wallago/kagu/CHANGELOG.md

# Changelog

## 0.3.0 - 2026-11-07

### 🚀 Features

- *(keymap)* Add session switch f2/f3 by @wallago
- *(keymap)* Add session switch f2/f3 by @wallago
- *(keymap)* Generate the keymap from keymap.txt and adopt a dubu36-style layout  by @wallago in [#20](https://github.com/wallago/kagu/pull/20)
- *(firmware)* Drive a 1.47" ST7789 status screen on the left half  by @wallago in [#11](https://github.com/wallago/kagu/pull/11)
- *(keymap)* Add home row mods and a Miryoku-style layer set  by @wallago in [#16](https://github.com/wallago/kagu/pull/16)

### 🛡️ Security

- *(deps)* Bump actions/download-artifact from 4 to 8  by @dependabot[bot] in [#1](https://github.com/wallago/kagu/pull/1)

## New Contributors
* @dependabot[bot] made their first contribution in [#5](https://github.com/wallago/kagu/pull/5)

**Full Changelog**: https://github.com/wallago/kagu/compare/v0.2.0...v0.3.0

## 0.2.0 - 2026-10-31

### 🚀 Features

- *(case)* Default tilted risers to a 2 mm post by @claude
- *(case)* Print tilted risers standing on the stem tip by @claude
- *(case)* Default the riser to no collar and render 15/25/35 degree leans by @claude
- *(case)* Add a collar-free riser option by @claude in [#9](https://github.com/wallago/kagu/pull/9)
- *(case)* Default the riser to the 0.5 mm post confirmed in print by @claude
- *(case)* Make the riser grip the switch and allow a 0.5 mm post by @claude
- *(case)* Tighten the riser stem and add tilted risers by @claude
- *(case)* Swap the tower caps for a straight Choc v2 riser by @claude
- *(case)* Add Choc v2 tower keycaps by @claude
- *(case)* Add five more top plate supports by @claude in [#7](https://github.com/wallago/kagu/pull/7)
- *(case)* Add support pillars under the top plate by @claude
- *(case)* Close battery JST window on top plate by @claude
- *(case)* Close reset hole and unused JST windows on top plate by @claude
- *(case)* Add top plate by @claude
- *(case)* Add a 1/4" nut mount at the tray's balance point by @claude in [#8](https://github.com/wallago/kagu/pull/8)
- *(case)* Add relief round the tray's heat-set inserts by @claude
- *(config)* Make full left layout by @wallago in [#3](https://github.com/wallago/kagu/pull/3)
- *(pcb)* Send to prod for one half (gl) by @wallago
- *(pcb)* Make a first no error version by @wallago
- *(pcb)* Init project by @wallago
- *(firware)* Add rgb led status by @wallago
- *(case)* Add bottom case and tilter by @wallago
- *(config)* Make both halves by @wallago
- *(pcb)* Match both sides by @wallago
- *(pcb/ritght)* Update it by @wallago
- *(pcb/right)* Initialize it by @wallago
- *(pcb)* Send to prod for one half (gl) by @wallago
- *(pcb)* Make a first no error version by @wallago
- *(pcb)* Init project by @wallago
- *(firware)* Add rgb led status by @wallago

### 🐛 Bug Fixes

- *(cd)* Release firmware and gerbers instead of a Rust binary  by @wallago in [#12](https://github.com/wallago/kagu/pull/12)
- *(case)* Stop mirroring switch rotations from the PCB by @claude
- *(ci)* Fix the jobs that fail on every run by @claude
- *(keymap)* Drop leftover merge conflict block by @claude in [#6](https://github.com/wallago/kagu/pull/6)
- *(pcb/left)* Adjust edge to fit right constraints by @wallago

### 🚜 Refactor

- *(pcb)* Rename it by @wallago

### 📚 Documentation

- *(case)* Say the riser stem is thickened, not opened up by @claude

### ⚙️ Miscellaneous Tasks

- *(release)* V0.2.0 by @wallago
- *(case)* Drop the tilter and the old one-piece case by @claude in [#10](https://github.com/wallago/kagu/pull/10)
- *(rebase)* Resolve to conflict by @wallago
- *(gitignore)* Update kicad ignored files by @wallago

## New Contributors
* @claude made their first contribution in [#10](https://github.com/wallago/kagu/pull/10)

**Full Changelog**: https://github.com/wallago/kagu/compare/v0.1.0...v0.2.0

## 0.1.0 - 2026-08-16

### 🚀 Features

- Add ZMK shield for single-key smoke test by @wallago

### 🐛 Bug Fixes

- *(zmk)* Move shield under config/ board root by @wallago
- *(zmk)* Chip as changing name by @wallago

## New Contributors
* @wallago made their first contribution

<!-- generated by git-cliff -->
