wallago/kagu/case/kagu_left_geom.scad

// GENERATED by case/extract_geometry.py -- do not edit.
// Source: pcb/kagu-left/kagu.kicad_pcb

board_w = 127;
board_h = 91.5;

// Board outline, counter-clockwise, origin at bounding-box corner.
outline = [ [0, 76.5], [0, 22], [26, 22], [30, 34], [41.5, 34], [53.5, 12.5], [72.5, 12.5], [106, 0], [127, 37], [127, 82.5], [77.5, 82.5], [77.5, 84.5], [61.5, 84.5], [61.5, 91.5], [40.5, 91.5], [40.5, 85.5], [22.5, 85.5], [22.5, 76.5] ];

// M3 mounting holes.
screws = [ [122, 35.5], [45, 35.5], [3.5, 25.5], [3.5, 73], [123.5, 79] ];

// Switch centres as [x, y, rotation].
switches = [ [15, 64.5, -0], [63, 21.5, -180], [87, 39.5, -0], [69, 41.5, -0], [51, 48.5, -0], [33, 76.5, -0], [51, 82.5, -0], [104, 15.5, 120], [87, 56.5, -0], [69, 75.5, -0], [83, 18.5, -160], [69, 58.5, -0], [87, 73.5, -0], [33, 59.5, -0], [15, 30.5, -0], [15, 47.5, -0], [51, 65.5, -0], [33, 42.5, -0] ];

// Components taller than the plate gap: [x0, y0, x1, y1].
tall_parts = [
    [111.5, 39.6, 119.5, 47.2],  // Switch_Con1
    [101.5, 39.6, 109.5, 47.2],  // Bat_Con1
    [103, 24.98, 108.7, 30.57],  // Bat_LED_Con1
];

// XIAO board cutout [x0, y0, x1, y1].
xiao = [101.8, 59.99, 119.6, 80.95];

// USB-C connector envelope [x0, y0, x1, y1].
usb = [106.2, 81.04, 115.2, 82.55];

// Reset button centre.
reset = [116, 32.5];
