wallago/kagu/case/kagu_right_geom.scad

// GENERATED by case/extract_geometry.py -- do not edit.
// Source: pcb/kagu-right/kagu.kicad_pcb

board_w = 127;
board_h = 91.5;

// Board outline, counter-clockwise, origin at bounding-box corner.
outline = [ [0, 37], [0, 82.5], [49.5, 82.5], [49.5, 84.5], [65.5, 84.5], [65.5, 91.5], [86.5, 91.5], [86.5, 85.5], [104.5, 85.5], [104.5, 76.5], [127, 76.5], [127, 22], [101, 22], [97, 34], [85.5, 34], [73.5, 12.5], [54.5, 12.5], [21, 0] ];

// M3 mounting holes.
screws = [ [5, 35.5], [82, 35.5], [123.5, 25.5], [123.5, 73], [3.5, 79] ];

// Switch centres as [x, y, rotation].
switches = [ [112, 64.5, -0], [64, 21.5, -180], [40, 39.5, -0], [58, 41.5, -0], [76, 48.5, -0], [94, 76.5, -0], [76, 82.5, -0], [23, 15.5, -120], [40, 56.5, -0], [58, 75.5, -0], [44, 18.5, 160], [58, 58.5, -0], [40, 73.5, -0], [94, 59.5, -0], [112, 30.5, -0], [112, 47.5, -0], [76, 65.5, -0], [94, 42.5, -0] ];

// Components taller than the plate gap: [x0, y0, x1, y1].
tall_parts = [
    [7.55, 39.6, 15.45, 47.2],  // Switch_Con1
    [17.55, 39.6, 25.45, 47.2],  // Bat_Con1
    [18.27, 24.98, 23.95, 30.57],  // Bat_LED_Con1
];

// XIAO board cutout [x0, y0, x1, y1].
xiao = [7.444, 59.99, 25.22, 80.95];

// USB-C connector envelope [x0, y0, x1, y1].
usb = [11.82, 81.04, 20.82, 82.55];

// Reset button centre.
reset = [11, 32.5];
