wallago/kagu/case/left.scad

// Entry point for the left half. Render with:
//   openscad -D 'part="bottom"' -o build/kagu_left_bottom.stl case/left.scad
include <kagu_left_geom.scad>
include <kagu_case.scad>
