wallago/kagu/case/left_tray.scad

// Entry point for the left half's bottom tray. Render with:
//   openscad -o build/kagu_left_tray.stl case/left_tray.scad
include <kagu_left_geom.scad>
include <kagu_tray.scad>
