wallago/kagu/case/right.scad

// Entry point for the right half. Render with:
//   openscad -D 'part="bottom"' -o build/kagu_right_bottom.stl case/right.scad
include <kagu_right_geom.scad>
include <kagu_case.scad>
