wallago/kagu/case/right_tray.scad

// Entry point for the right half's bottom tray. Render with:
//   openscad -o build/kagu_right_tray.stl case/right_tray.scad
include <kagu_right_geom.scad>
include <kagu_tray.scad>
