wallago/kagu/pcb/kagu-right/kagu.kicad_pcb

## KiCad design pcb/kagu-right/kagu.kicad_pcb (2026-09-24)

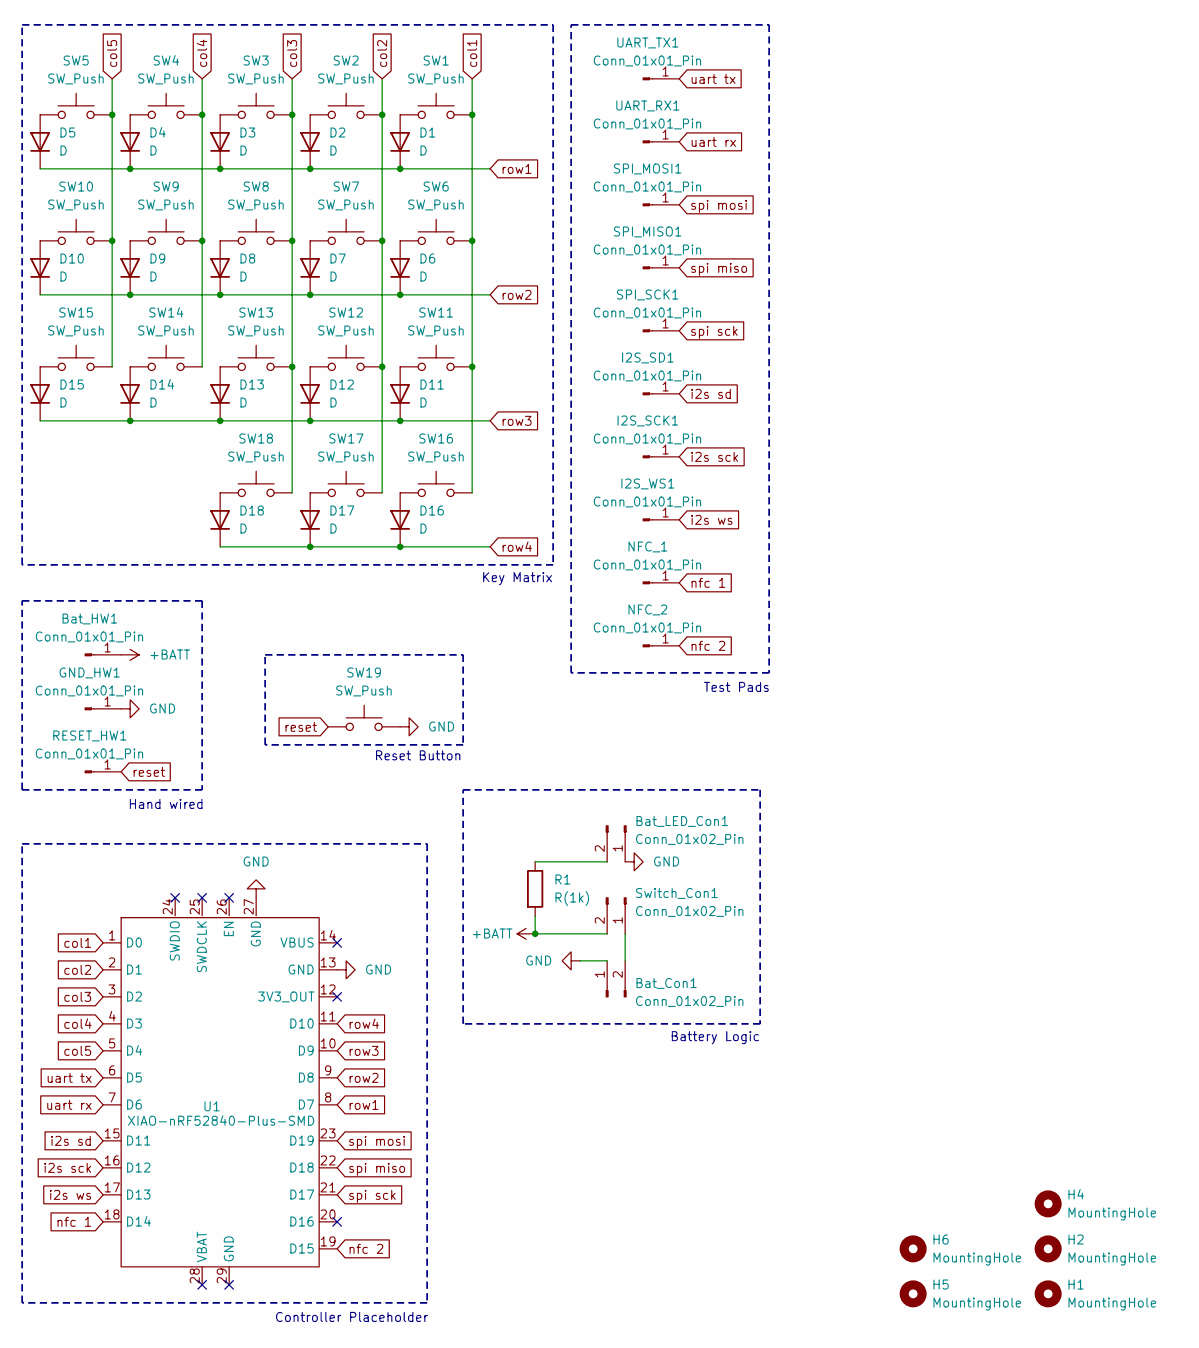
[picture p1: schematic kagu.kicad_sch]

Parts:
Bat_Con1: Conn_01x02_Pin; JST_PH_S2B-PH-SM4-TB_1x02-1MP_P2.00mm_Horizontal
Bat_HW1: Conn_01x01_Pin; TestPad
Bat_LED_Con1: Conn_01x02_Pin; JST_SH_SM02B-SRSS-TB_1x02-1MP_P1.00mm_Horizontal
D1, D2, D3, D4, D5, D6, D7, D8, D9, D10, D11, D12, D13, D14, D15, D16, D17, D18: D; D_SOD-123
GND_HW1: Conn_01x01_Pin; TestPad
H1, H2, H4, H5, H6: MountingHole; MountingHole_3.2mm_M3_DIN965_Pad
I2S_SCK1, I2S_SD1, I2S_WS1: Conn_01x01_Pin; TestPad
NFC_1, NFC_2: Conn_01x01_Pin; TestPad
R1: R(1k); R_0805_2012Metric
RESET_HW1: Conn_01x01_Pin; TestPad
SPI_MISO1: Conn_01x01_Pin; TestPad
SPI_MOSI1: Conn_01x01_Pin; TestPad
SPI_SCK1: Conn_01x01_Pin; TestPad
SW1, SW2, SW3, SW4, SW5, SW6, SW7, SW8, SW9, SW10, SW11, SW12, SW13, SW14, SW15, SW16, SW17, SW18: SW_Push; SW_Hotswap_Kailh_Choc_V1V2_Plated
SW19: SW_Push; SW_Push_SPST_NO_Alps_SKRK
Switch_Con1: Conn_01x02_Pin; JST_PH_S2B-PH-SM4-TB_1x02-1MP_P2.00mm_Horizontal
U1: XIAO-nRF52840-Plus-SMD; XIAO-23P-Add-On-Plus
UART_RX1: Conn_01x01_Pin; TestPad
UART_TX1: Conn_01x01_Pin; TestPad

Connections:
+BATT: Bat_HW1.1 (Pin_1_1), R1.2, Switch_Con1.2
GND: Bat_Con1.1, Bat_LED_Con1.1, GND_HW1.1 (Pin_1_1), SW19.2, U1.13 (GND), U1.27 (GND)
unnamed: Bat_Con1.2, Switch_Con1.1
unnamed: Bat_LED_Con1.2, R1.1
unnamed: D1.2 (A), SW1.1
unnamed: D2.2 (A), SW2.1
unnamed: D3.2 (A), SW3.1
unnamed: D4.2 (A), SW4.1
unnamed: D5.2 (A), SW5.1
unnamed: D6.2 (A), SW6.1
unnamed: D7.2 (A), SW7.1
unnamed: D8.2 (A), SW8.1
unnamed: D9.2 (A), SW9.1
unnamed: D10.2 (A), SW10.1
unnamed: D11.2 (A), SW11.1
unnamed: D12.2 (A), SW12.1
unnamed: D13.2 (A), SW13.1
unnamed: D14.2 (A), SW14.1
unnamed: D15.2 (A), SW15.1
unnamed: D16.2 (A), SW16.1
unnamed: D17.2 (A), SW17.1
unnamed: D18.2 (A), SW18.1
col1: SW1.2, SW6.2, SW11.2, SW16.2, U1.1 (D0)
col2: SW2.2, SW7.2, SW12.2, SW17.2, U1.2 (D1)
col3: SW3.2, SW8.2, SW13.2, SW18.2, U1.3 (D2)
col4: SW4.2, SW9.2, SW14.2, U1.4 (D3)
col5: SW5.2, SW10.2, SW15.2, U1.5 (D4)
i2s sck: I2S_SCK1.1 (Pin_1_1), U1.16 (D12)
i2s sd: I2S_SD1.1 (Pin_1_1), U1.15 (D11)
i2s ws: I2S_WS1.1 (Pin_1_1), U1.17 (D13)
nfc 1: NFC_1.1 (Pin_1_1), U1.18 (D14)
nfc 2: NFC_2.1 (Pin_1_1), U1.19 (D15)
reset: RESET_HW1.1 (Pin_1_1), SW19.1
row1: D1.1 (K), D2.1 (K), D3.1 (K), D4.1 (K), D5.1 (K), U1.8 (D7)
row2: D6.1 (K), D7.1 (K), D8.1 (K), D9.1 (K), D10.1 (K), U1.9 (D8)
row3: D11.1 (K), D12.1 (K), D13.1 (K), D14.1 (K), D15.1 (K), U1.10 (D9)
row4: D16.1 (K), D17.1 (K), D18.1 (K), U1.11 (D10)
spi miso: SPI_MISO1.1 (Pin_1_1), U1.22 (D18)
spi mosi: SPI_MOSI1.1 (Pin_1_1), U1.23 (D19)
spi sck: SPI_SCK1.1 (Pin_1_1), U1.21 (D17)
uart rx: U1.7 (D6), UART_RX1.1 (Pin_1_1)
uart tx: U1.6 (D5), UART_TX1.1 (Pin_1_1)

Notes on the sheet:
Reset Button
Key Matrix
Test Pads
Controller Placeholder
Hand wired
Battery Logic

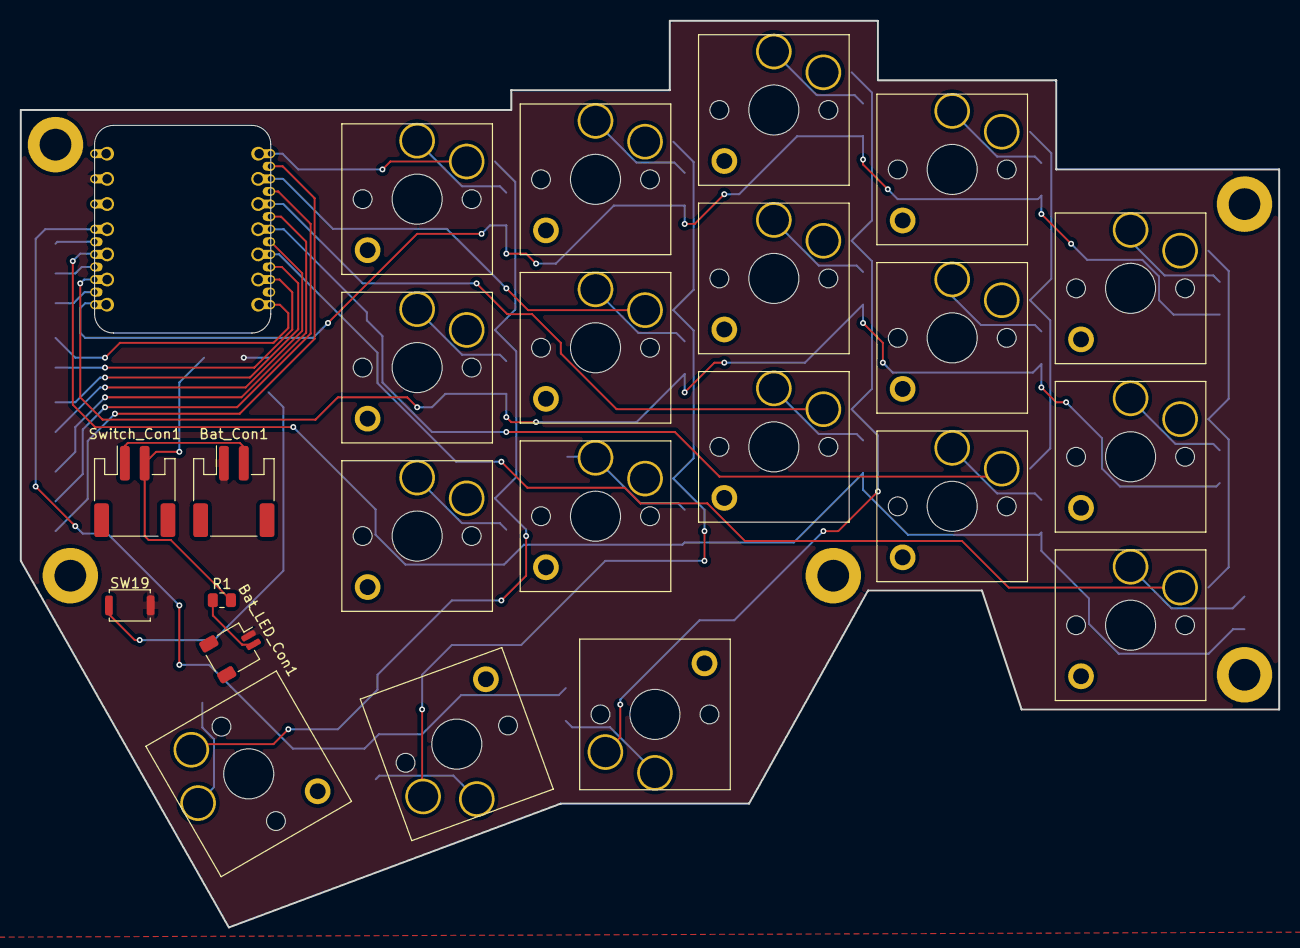
[picture p2: board kagu.kicad_pcb from above]

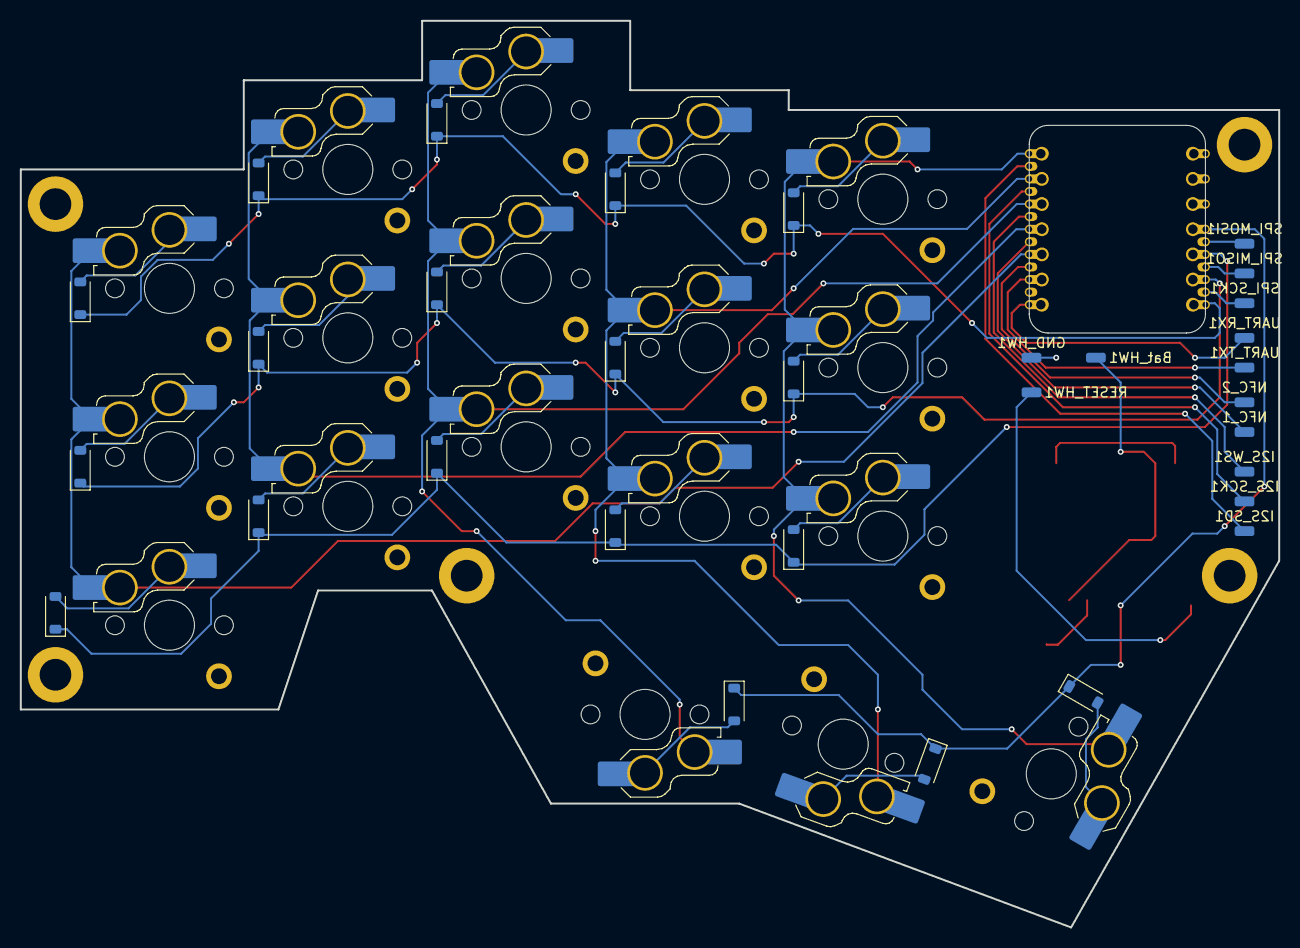
[picture p3: board kagu.kicad_pcb from below]

Board: 2 copper layers, 127.0 x 91.5 mm, 60 parts (6 on the bottom side), 42 nets.
