wallago/kagu/config/boards/shields/kagu/kagu_left.overlay

#include "kagu.dtsi"

&kscan0 {
    // Left half: physical left-to-right is col5 -> col1, i.e. D4 -> D0.
    col-gpios
        = <&xiao_d 4 GPIO_ACTIVE_HIGH>   // col5
        , <&xiao_d 3 GPIO_ACTIVE_HIGH>   // col4
        , <&xiao_d 2 GPIO_ACTIVE_HIGH>   // col3
        , <&xiao_d 1 GPIO_ACTIVE_HIGH>   // col2
        , <&xiao_d 0 GPIO_ACTIVE_HIGH>   // col1
        ;
};
