wallago/kagu/(commit log)

2026-08-16 feat: add ZMK shield for single-key smoke test
    Scaffolds a 1x1 kscan matrix on the Seeed XIAO nRF52840 (D0 -> diode ->
    switch -> D1) so the wiring can be verified before the full split.
    Firmware is built by GitHub Actions via ZMK's build-user-config workflow.
2026-08-16 fix(zmk): move shield under config/ board root
2026-08-17 feat(firware): add rgb led status
2026-08-18 feat(pcb): init project
    [kagu.kicad_pcb, kagu.kicad_sch]
2026-08-19 feat(pcb): make a first no error version
    [kagu.kicad_pcb, kagu.kicad_sch]
2026-08-19 feat(pcb): send to prod for one half (gl)
    [kagu.kicad_pcb, kagu.kicad_sch]
2026-09-21 refactor(pcb): rename it
    [kagu.kicad_pcb, kagu.kicad_sch]
2026-09-23 feat(pcb/right): initialize it
    [kagu.kicad_pcb, kagu.kicad_sch]
2026-09-23 fix(pcb/left): adjust edge to fit right constraints
    [kagu.kicad_pcb]
2026-09-24 feat(pcb/ritght): update it
    [kagu.kicad_pcb, kagu.kicad_sch]
2026-09-24 chore(gitignore): update kicad ignored files
2026-09-24 feat(pcb): match both sides
    [kagu.kicad_pcb, kagu.kicad_sch]
2026-10-20 feat(case): add bottom case and tilter
2026-10-26 feat(case): add relief round the tray's heat-set inserts
    Pressing an M3 insert in raises a lip of plastic round the hole that
    lifts the PCB off the boss. A 5.5mm x 0.6mm counterbore at the top of
    each boss gives that lip room below the PCB seat, and the hole runs
    1mm past the insert for the melt it pushes down.
    Claude-Session: https://claude.ai/code/session_01D4U1sUtxfp9hYvJTTRMZK1
2026-10-26 fix(ci): fix the jobs that fail on every run
    Pin committed to v1.1.9 (the action has no master ref any more), let
    lychee pass when the Markdown has no links, whitelist the XIAO
    footprint name for typos, and drop nix build since the flake has no
    package to build.
    Claude-Session: https://claude.ai/code/session_013yxdbe8upfP4isyMcjDqjK
2026-10-26 feat(case): add a 1/4" nut mount at the tray's balance point
    A 1/4"-20 hex nut trapped in a floor boss takes a magic arm or tripod
    screw from underneath. It sits between the mass centroid of the
    assembled half and the key centroid, mirrored for the right half, clear
    of the battery, the XIAO and the PCB bosses.
    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
2026-10-27 feat(case): add top plate
    Switch plate plus a 2.2mm skirt that lands on the bottom tray's border,
    reusing the tray's profiles so the outline and cable swell match. The
    five PCB screws clamp plate, PCB and tray together through spacers under
    the plate, countersunk for M3 x 8 flat heads (DIN 965 footprints).
    The tray file no longer renders on include; its entry points call
    bottom_tray() so kagu_top.scad can build on it. Tray output unchanged.
    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
2026-10-27 feat(case): close reset hole and unused JST windows on top plate
    Only the battery JST keeps a window. The switch and battery-LED
    connectors stay unpopulated until the ledge is wired.
    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
2026-10-27 feat(case): close battery JST window on top plate
    No JST connectors are fitted, so the plate now covers all three
    footprints.
    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
2026-10-27 fix(case): stop mirroring switch rotations from the PCB
    The Y flip keeps the drawing the right way round, so KiCad's rotations
    carry over as they are. Negating them turned the four angled thumb keys
    the wrong way (20 deg instead of -20, 30 instead of -30 and mirrored),
    off the board edges they follow.
    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
2026-10-27 feat(case): add support pillars under the top plate
    Fifteen 2.4mm pillars per half rest on the PCB so the plate does not
    flex when typing: three per column gap, plus the open areas round the
    thumb cluster and the battery connector. Placed on bare board, clear of
    front pads and of the switch latches.
    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
2026-10-27 feat(case): add five more top plate supports
    Beside the outer key columns, between the thumbs and above the far
    thumb key, where the plate still had long unsupported spans.
    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
2026-10-27 feat(case): add Choc v2 tower keycaps
    Tall rounded-block caps that sit straight on the Choc v2 stem, with an
    optional sloped top face. Printed top face down so the socket points up
    and nothing needs supports. `just towers` renders a starter set.
    Claude-Session: https://claude.ai/code/session_01VHfAVHMdEDq9g4dPNaGWED
2026-10-27 feat(case): swap the tower caps for a straight Choc v2 riser
    A round post the diameter of the v2 stem tube, with the tilter's v2
    socket underneath and its MX cross on top, so a normal keycap plugs on.
    Nothing overhangs, so it prints socket down with no supports.
    `just risers` renders 3, 5 and 8 mm.
    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
2026-10-27 feat(case): tighten the riser stem and add tilted risers
    Printed caps had a little play on the riser's MX cross, so open it up by
    0.05 on both arms. Add `tilt`/`azimuth` like the tilter: only the top and
    stem lean, the post stays straight, so it still prints without supports.
    `just risers` adds a 1 mm riser and a 2 mm, 15 degree one.
    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
2026-10-27 docs(case): say the riser stem is thickened, not opened up
    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
2026-10-27 feat(case): make the riser grip the switch and allow a 0.5 mm post
    A printed riser lifted off the switch with no force, so tighten the
    socket: cross hole 0.05 over the stem cross (was 0.15) and boss 0.10
    under the bore (was 0.20). Cut the hole overshoot to 0.10 and the roof
    over it to two 0.2 layers, so the post can drop to 0.5 mm.
    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
2026-10-27 feat(case): default the riser to the 0.5 mm post confirmed in print
    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
2026-10-27 feat(case): add a collar-free riser option
    With collar=false the post is as thin as the boss, so there is no ring
    on the stem rim and the riser seats on the cross top instead.
    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
2026-10-30 feat(case): default the riser to no collar and render 15/25/35 degree leans
    Drop the collar by default and take `height` at the post's lowest edge,
    so every lean keeps the 0.5 mm confirmed in print at its thinnest point.
    `just risers` now renders only the straight riser plus 15, 25 and 35
    degree square and diagonal leans.
    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
2026-10-30 feat(case): print tilted risers standing on the stem tip
    A leaning MX stem printed socket down came out with stringy, sagging
    arms. Tilted risers now export upside down on the stem tip, so the cross
    prints straight up and the round boss takes the lean instead. The face
    under the stem bridges at most ~1.3 mm between the arms. Straight risers
    still print socket down.
    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
2026-10-30 feat(case): default tilted risers to a 2 mm post
    Printed and confirmed: 0.5 mm suits the straight riser, but a 15 degree
    one sat too low and 2 mm at the low edge looked right.
    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
2026-10-30 chore(case): drop the tilter and the old one-piece case
    choc_v2_tilter.scad is superseded by the riser, and kagu_case.scad with
    its left/right entry points by the tray + top plate. Remove them with
    their `just tilters` and `just case` recipes, and fold the tilter's
    datasheet notes into the riser.
    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
2026-10-31 fix(cd): release firmware and gerbers instead of a Rust binary (#12)
    <!-- claude-projects-attribution: {"github_login":"wallago"} -->
    _Requested by **Hugo Henrotte** · [project
    thread](https://claude.ai/code/project/chan_01HhQqjkmz5pcB9sVm2CZKLL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)_
    Prepares the repo for its first tagged release (`v0.1.0`, marking the
    current r1 boards before a PCB revision).
    - `cd.yml` was still the Rust template (cargo/cross build, Cargo.toml
    version check), so any `v*.*.*` tag would fail. It now builds the ZMK
    firmware with the same reusable workflow as `build.yml`, then publishes
    a GitHub release with the `.uf2` files, `kagu-left-gerbers.zip`,
    `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
2026-11-05 feat(keymap): add home row mods and a Miryoku-style layer set (#16)
    thread](https://claude.ai/code/project/chan_01HhQqjkmz5pcB9sVm2CZKLL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)_
    ## Description of change
    Brings Hugo's previous keymap (Colemak-DH, home row mods, Miryoku-style
    thumbs) to Kagu's 36 keys, fixing what kept it from building:
    - **Thumbs:** one row of 6 thumb keys (the old base layer had 8, so
    every layer's count was off). Thumbs are `&lt MEDIA ESC`, `&lt NAV
    SPACE`, `&lt MOUSE TAB` | `&lt SYM RET`, `&lt NUM BSPC`, `&lt FUN DEL`.
    - **Missing layers:** `F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
2026-11-07 feat(firmware): drive a 1.47" ST7789 status screen on the left half (#11)
    thread](https://claude.ai/code/project/chan_01HhQqjkmz5pcB9sVm2CZKLL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)_
    First step toward a status screen: show the active layer name on the
    1.47" 172x320 ST7789 IPS TFT (8-pin FPC) on the left (central) half. It
    uses ZMK's built-in status screen. Its layer widget prints each layer's
    `display-name` (Base/Nav/Sym/Sys), and the screen also shows battery and
    output status. No custom UI code yet.
    - `kagu_left.overlay`: `zephyr,mipi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
2026-11-07 feat(keymap): generate the keymap from keymap.txt and adopt a dubu36-style layout (#20)
    _Requested by **Wallago** · [project
    thread](https://claude.ai/code/project/chan_01HhQqjkmz5pcB9sVm2CZKLL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)_
    Brings the keymap setup and layout of
    [denniskempin/dubu36](https://github.com/denniskempin/dubu36) to Kagu.
    It also adds a keymap-drawer diagram and a README.
    ## Commit 1: keymap.txt and a generator (no layout change)
    - `keymap.txt` is now the only file to edit. Each layer is a 36-key grid
    (`TAP`, `TAP/HOLD`, `TAP/HOLD:hm`, `_`, `TRNS`), overlays share the
    home-row holds, a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
2026-11-07 feat(keymap): add session switch f2/f3
2026-11-09 feat(keymap): add a one-handed game layer for Dofus (#21)
    thread](https://claude.ai/code/project/chan_01HhQqjkmz5pcB9sVm2CZKLL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)_
    A left-hand-only layer for Dofus, with the right hand on the mouse.
    - **Enter**: hold Z (sys), tap G. **Leave**: hold the inner thumb
    (menu), tap the top-left key.
    - **game**: spells 1-5 on the top row and 6-0 on the home row; Shift,
    Ctrl, Alt, Tab, Enter on the bottom row; Esc, Space (end turn) and the
    menu hold on the thumbs. Every key is a plain press, no hold-tap, so
    nothing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
